immortal-sniper1/GMWPY_UPB2023/doc/BoM.xlsx

MOUSER part No | price [Euro] | amout min | recomaded amount |  | type
80-USEQGCDACH4100 | 90.5 | 1 | 1 | 90.5 | sensor CH4
523-EC4-1000-H2 | 158 | 1 | 1 | 158 | sensor H2
511-TSV7721ILT | 1.1 | 5 | 10 | 11 | op amp/buffer
926-LMP7717MFX/NOPB | 2.2 | 0 | 0 | 0 | op amp alt
863-MMBFJ177LT1G | 0.44 | 1 | 5 | 2.2 | Jfet p
595-LM4040D20IDBZR | 0.73 | 1 | 2 | 1.46 | reference 2.048V | https://ro.mouser.com/c/semiconductors/power-management-ics/voltage-references/?q=LM4040D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
356-ESP32S3WROM1N4R2 | 3.1 | 1 | 2 | 6.2 | MCU
640-USB1040-GF-L-B | 0.52 | 1 | 2 | 1.04 | USB
579-MCP3422A1-E/SN | 3.7 | 1 | 2 | 7.4 | ADC 18bit
579-MCP3422A0-E/SN | 3.7 | 1 | 2 | 7.4 | ADC 18bit | https://ro.mouser.com/c/semiconductors/data-converter-ics/analog-to-digital-converters-adc/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
262-BME280 | 6 | 1 | 2 | 12 | temp press hum sensor
Farnell
3546297 | 96 | 1 |  |  | CH4 sensor
1654684 | 0.4 | 3 | 10 | 4 | H2 sensor socket
JLCPCB
- | 39.5 | 1 | 1 | 39.5 | PCB+ pasive | remember that we can assemble 2 or 5 pieces with or without the MCU
 |  |  |  |  |  | All amounts are for 1 device
sensors | 254
te other parts | 92.2
total | 346.2
