immortal-sniper1/GMWPY_UPB2023/doc/USEQGCDACH4100.step

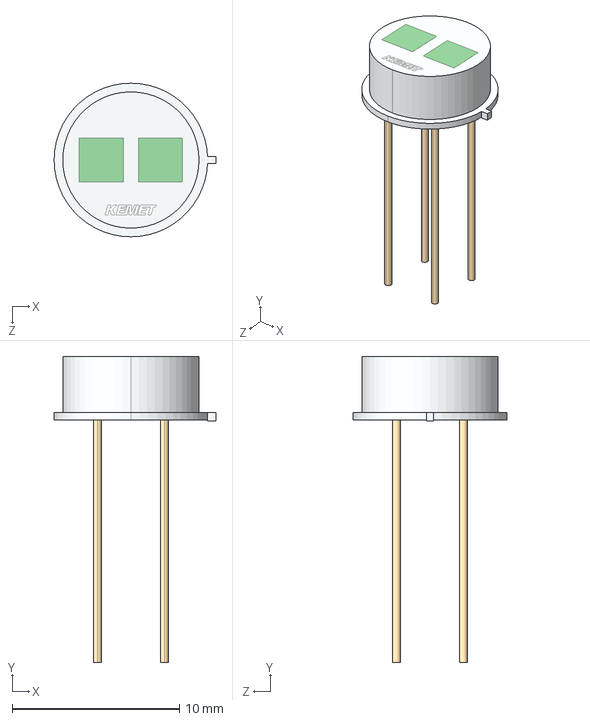
[picture p6: CAD file, 2023-03-01]
doc/USEQGCDACH4100.step
9.68 x 18.3 x 9.19 mm
