immortal-sniper1/GMWPY_UPB2023/HW/GMWPY/GMWPY.step

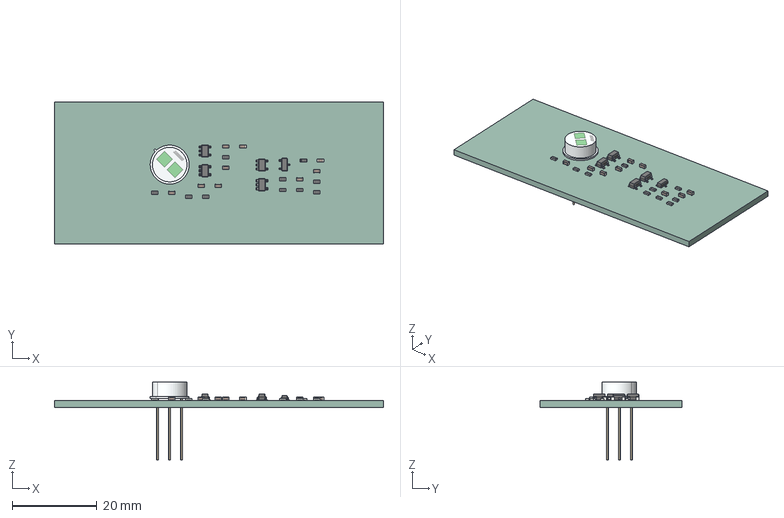
[picture p7: CAD file, 2023-03-01]
HW/GMWPY/GMWPY.step
77.6 x 33.4 x 18.3 mm
_autosave-GMWPY PCB
