immortal-sniper1/GMWPY_UPB2023/HW/schematic.pdf

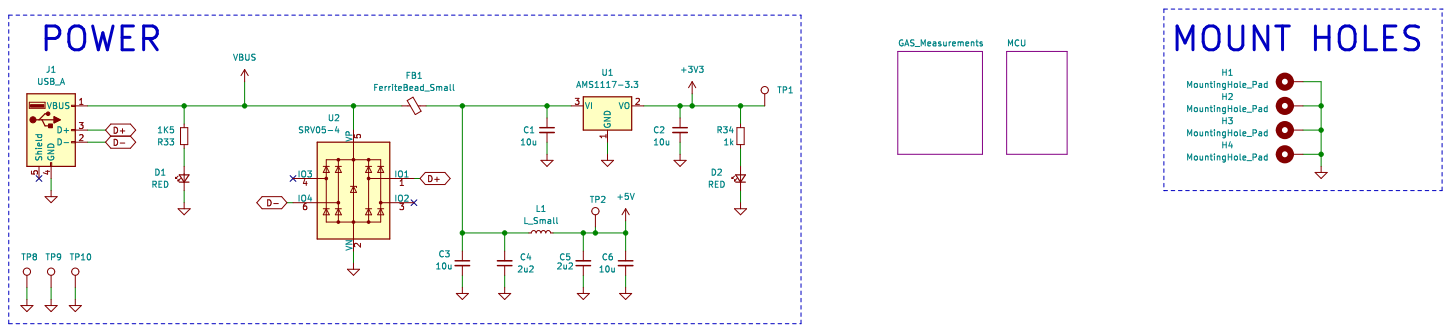
[picture p8: page 1]

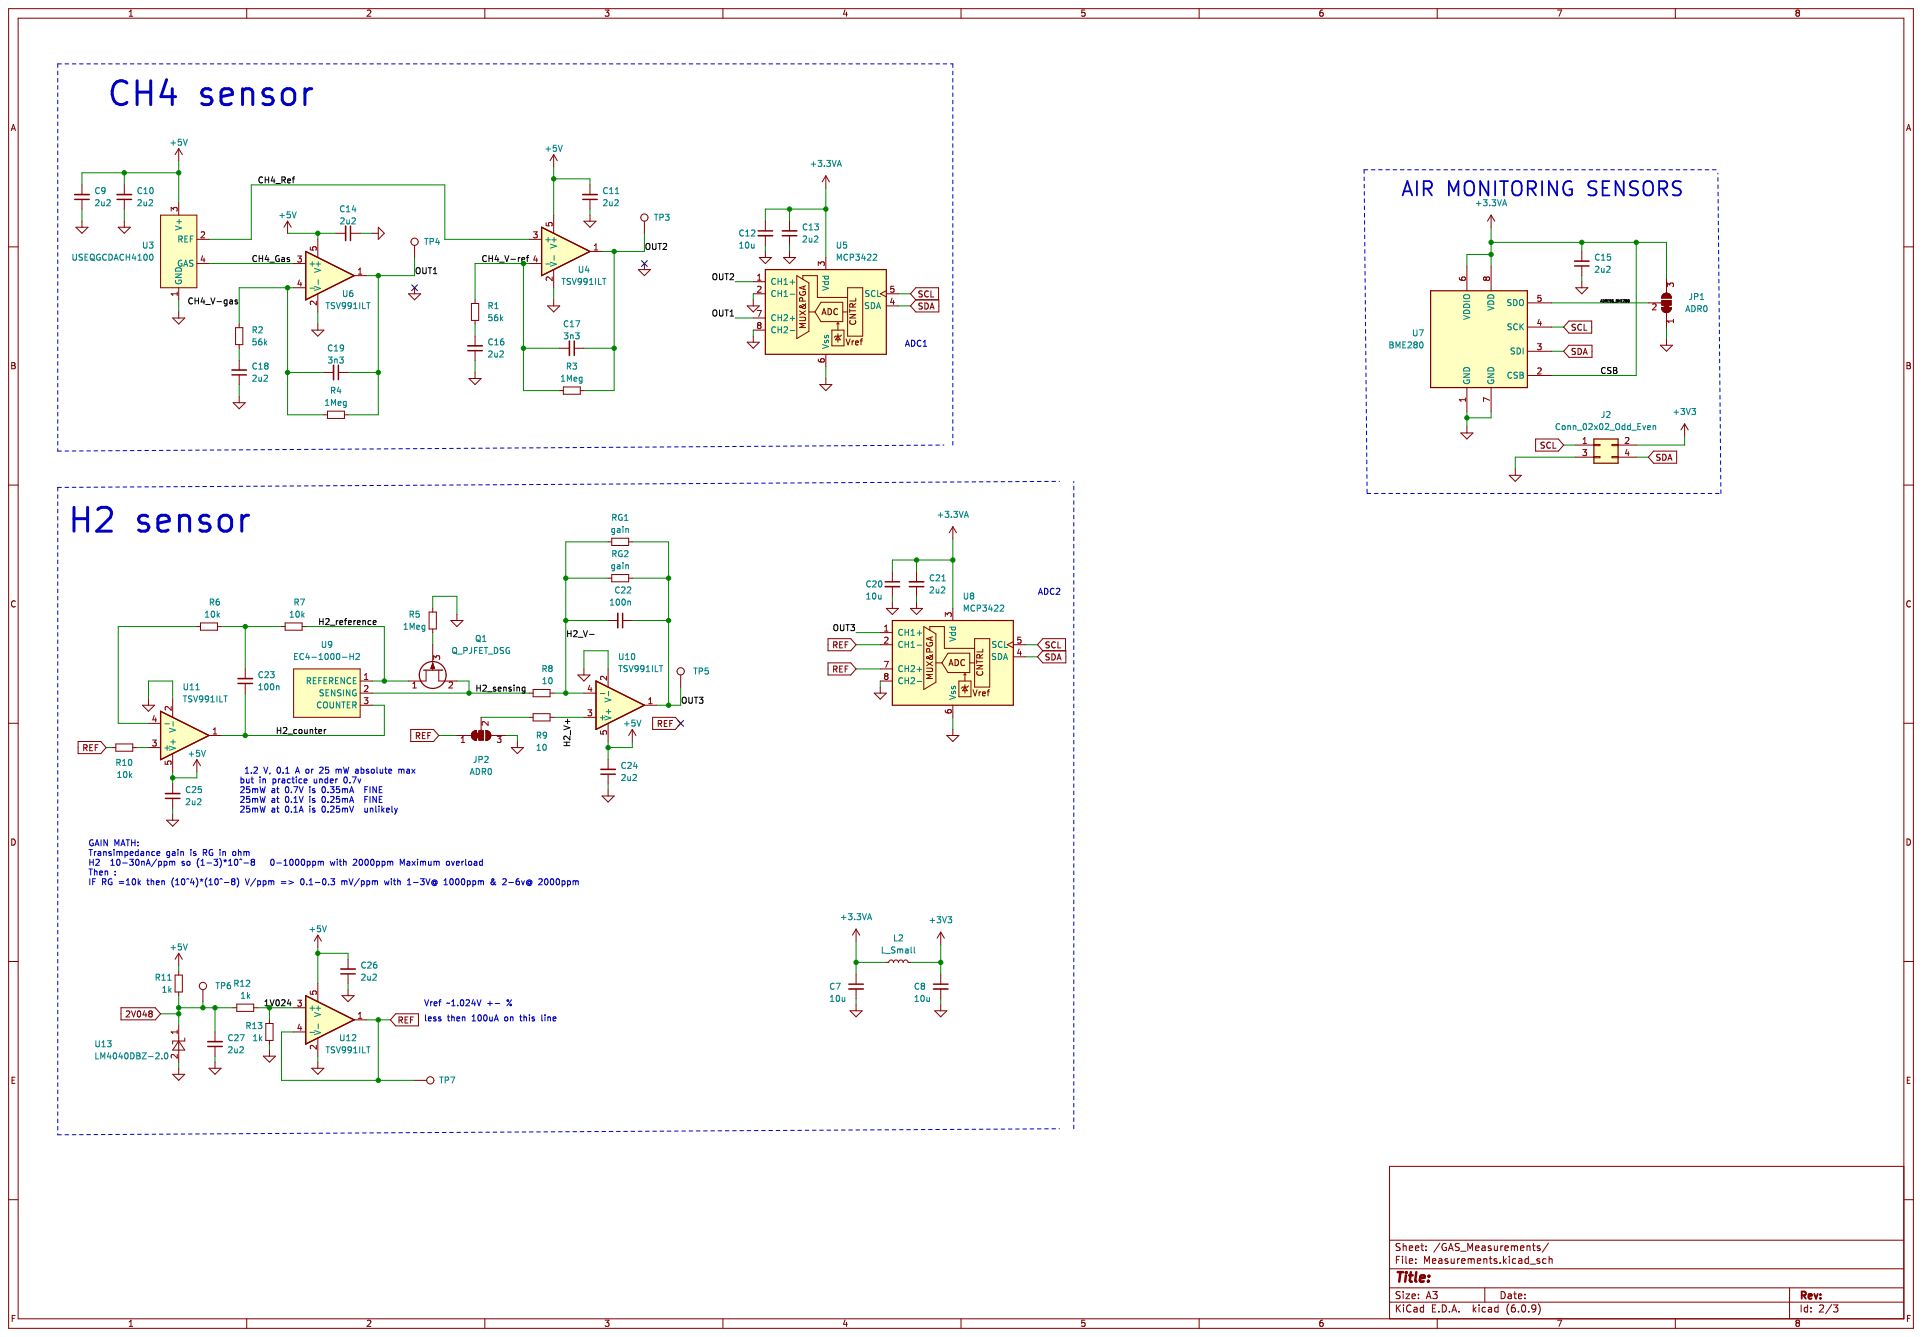
[picture p9: page 2]

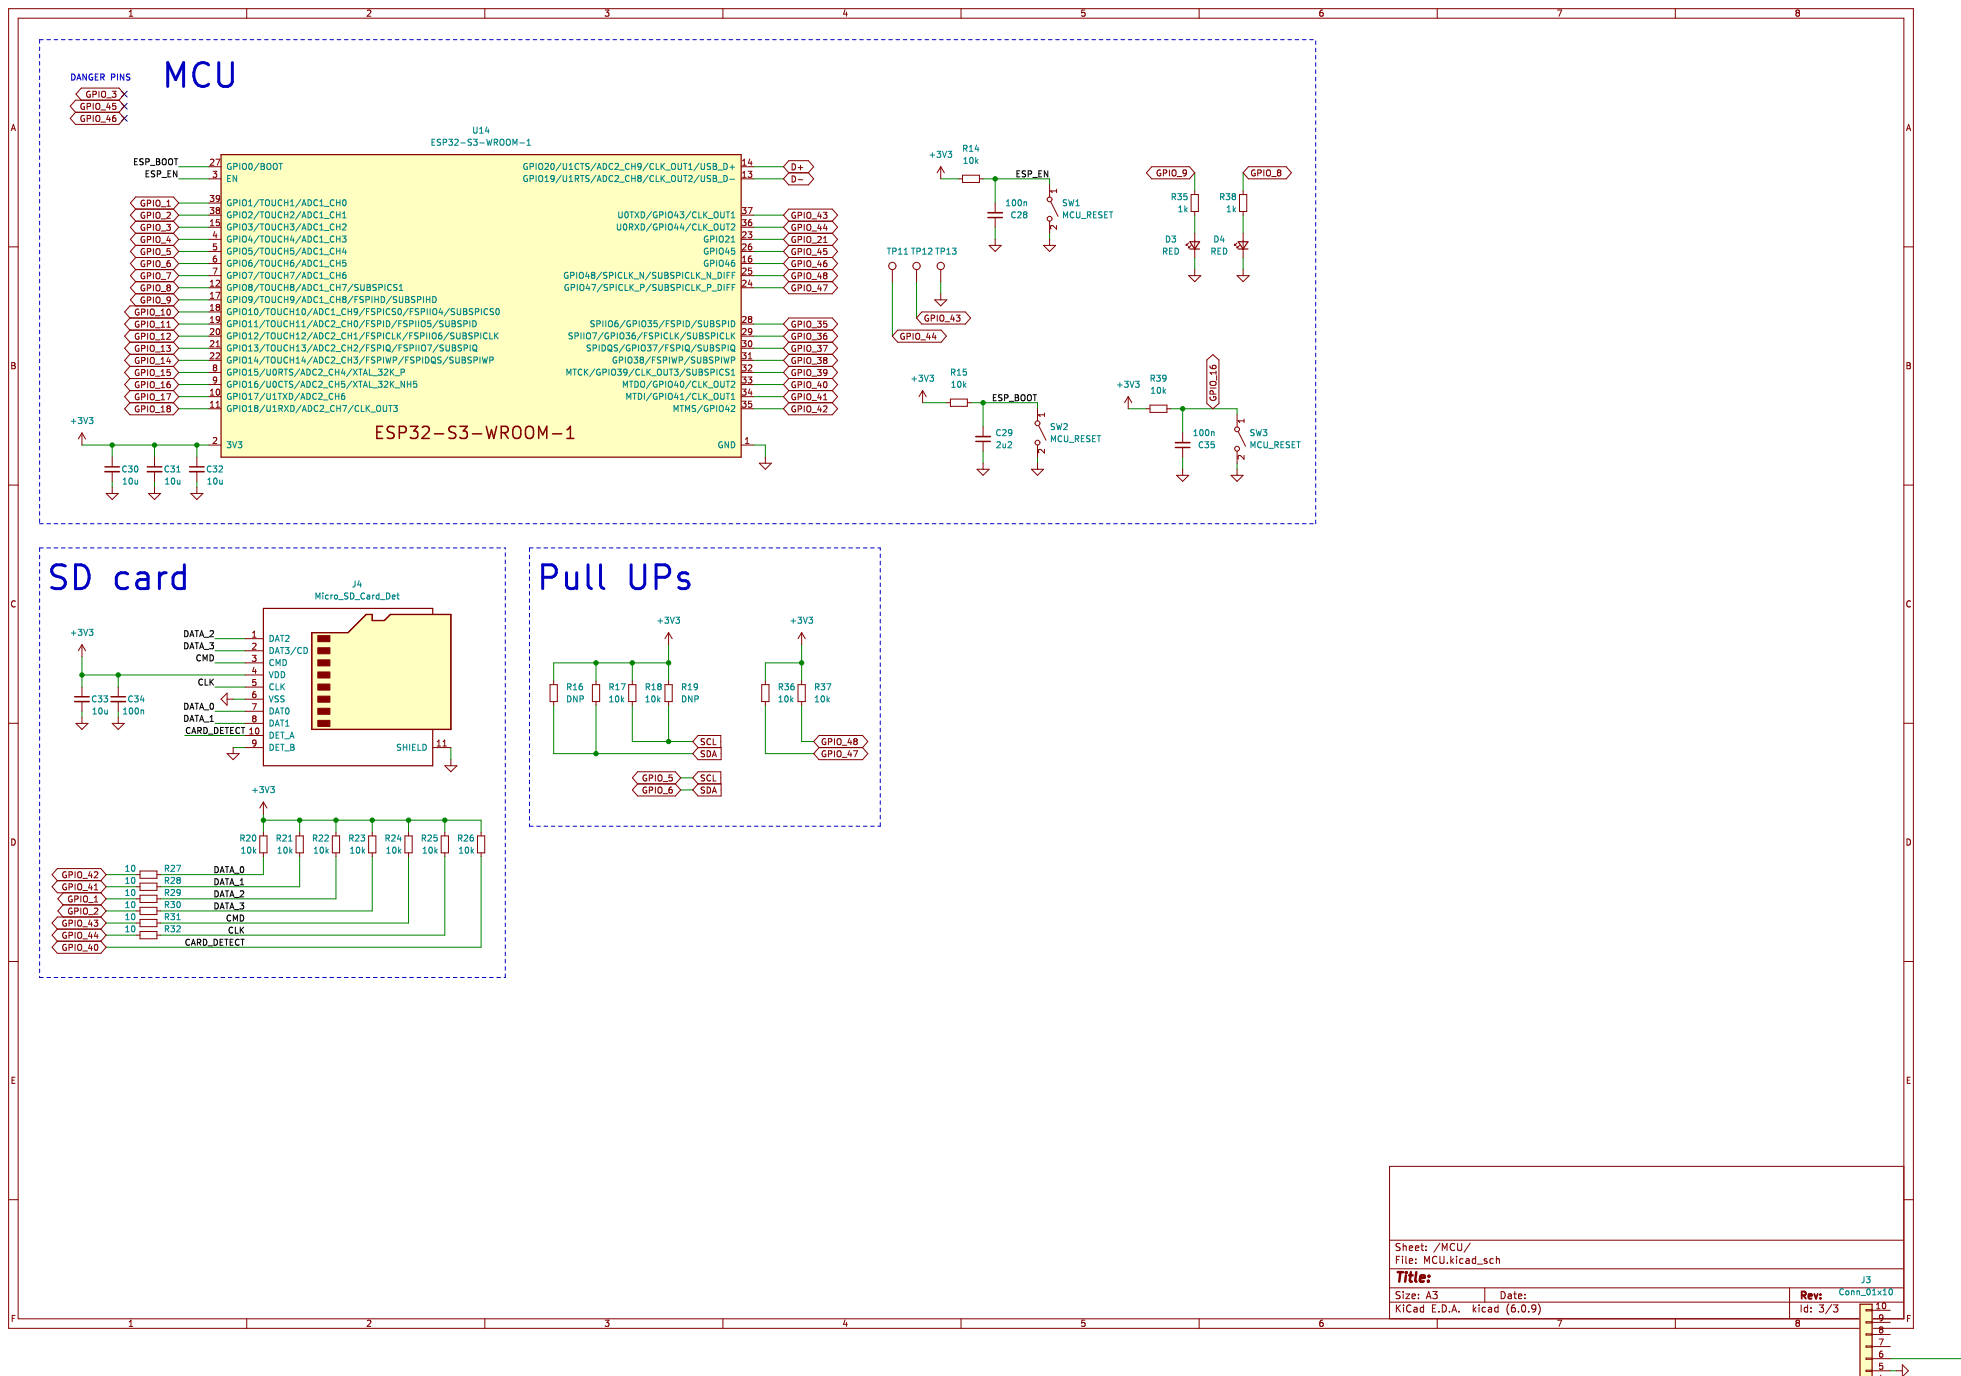
[picture p10: page 3]
