immortal-sniper1/GMWPY_UPB2023/HW/GMWPY/GMWPY.kicad_pcb

## KiCad design HW/GMWPY/GMWPY.kicad_pcb (2023-03-27)

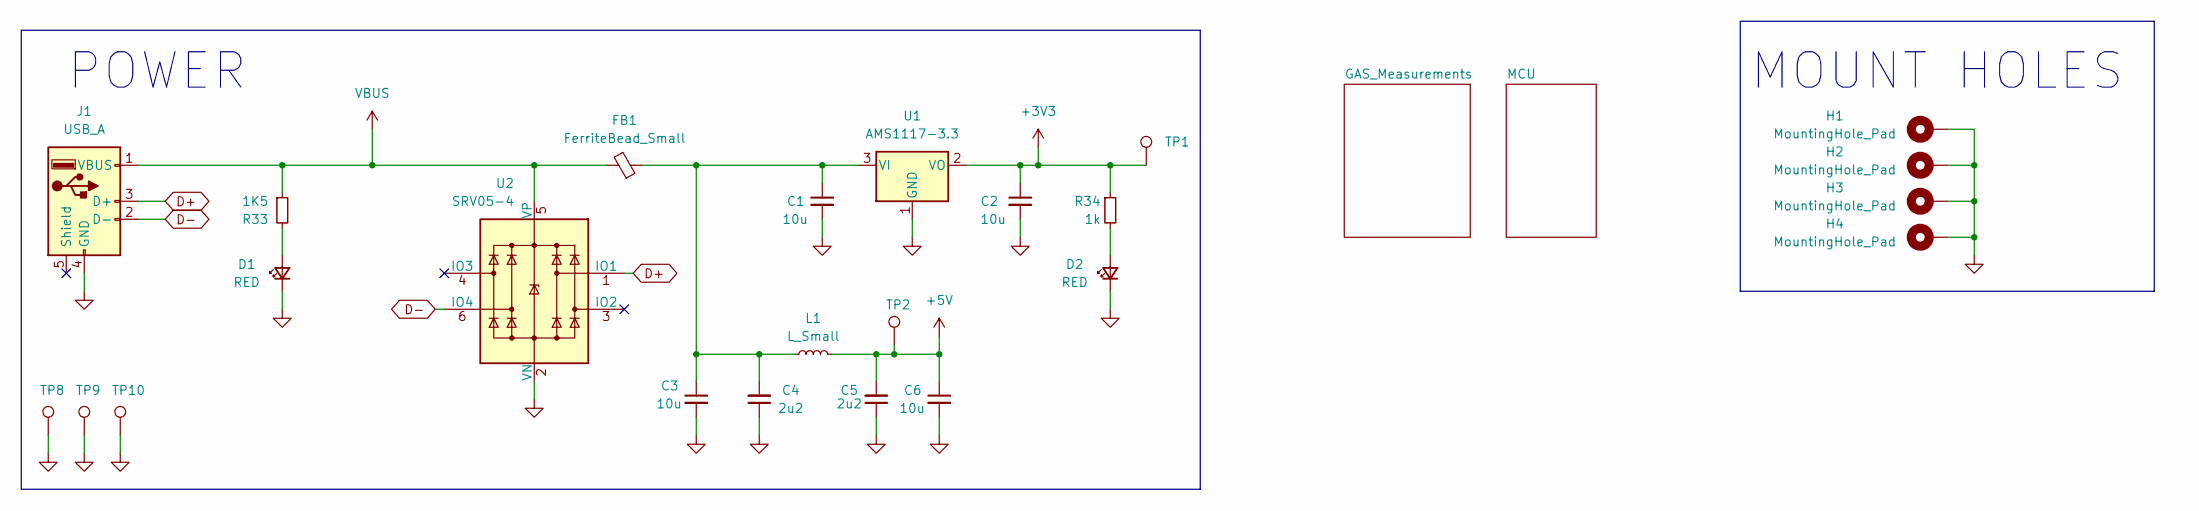
[picture p11: schematic GMWPY.kicad_sch, Gas_sensor_board]

Parts:
C1, C2, C3, C6: 10u; C_0805_2012Metric; LCSC C15850
C4, C5: 2u2; C_0603_1608Metric; LCSC C23630
D1, D2: RED; LED_0603_1608Metric; LCSC C2286
FB1: FerriteBead_Small; L_0805_2012Metric; LCSC C1015
H1, H2, H3, H4: MountingHole_Pad; MountingHole_3.2mm_M3_DIN965_Pad_TopBottom
J1: USB_A; USB1040GFLB
L1: L_Small; L_0603_1608Metric; LCSC C13415
R33: 1K5; R_0603_1608Metric; LCSC C22843
R34: 1k; R_0603_1608Metric; LCSC C21190
TP1, TP2, TP8, TP9, TP10: TestPoint; TestPoint_Pad_1.5x1.5mm
U1: AMS1117-3.3; SOT-223-3_TabPin2; LCSC C6186
U2: SRV05-4; SOT-23-6; LCSC C85364

Connections:
+3V3: C2.1, R34.1, TP1.1, U1.2 (VO); also elsewhere on the board
+5V: C5.2, C6.1, L1.2, TP2.1; also elsewhere on the board
D+: J1.3 (D+), U2.1 (IO1); also elsewhere on the board
D-: J1.2 (D-), U2.6 (IO4); also elsewhere on the board
GND: C1.2, C2.2, C3.2, C4.1, C5.1, C6.2, D1.1 (K), D2.1 (K), H1.1, H2.1, H3.1, H4.1, J1.4 (GND), TP8.1, TP9.1, TP10.1, U1.1 (GND), U2.2 (VN); also elsewhere on the board
unnamed: C1.1, C3.1, C4.2, FB1.1, L1.1, U1.3 (VI)
unnamed: D1.2 (A), R33.2
unnamed: D2.2 (A), R34.2
VBUS: FB1.2, J1.1 (VBUS), R33.1, U2.5 (VP); also elsewhere on the board

Notes on the sheet:
POWER
MOUNT HOLES

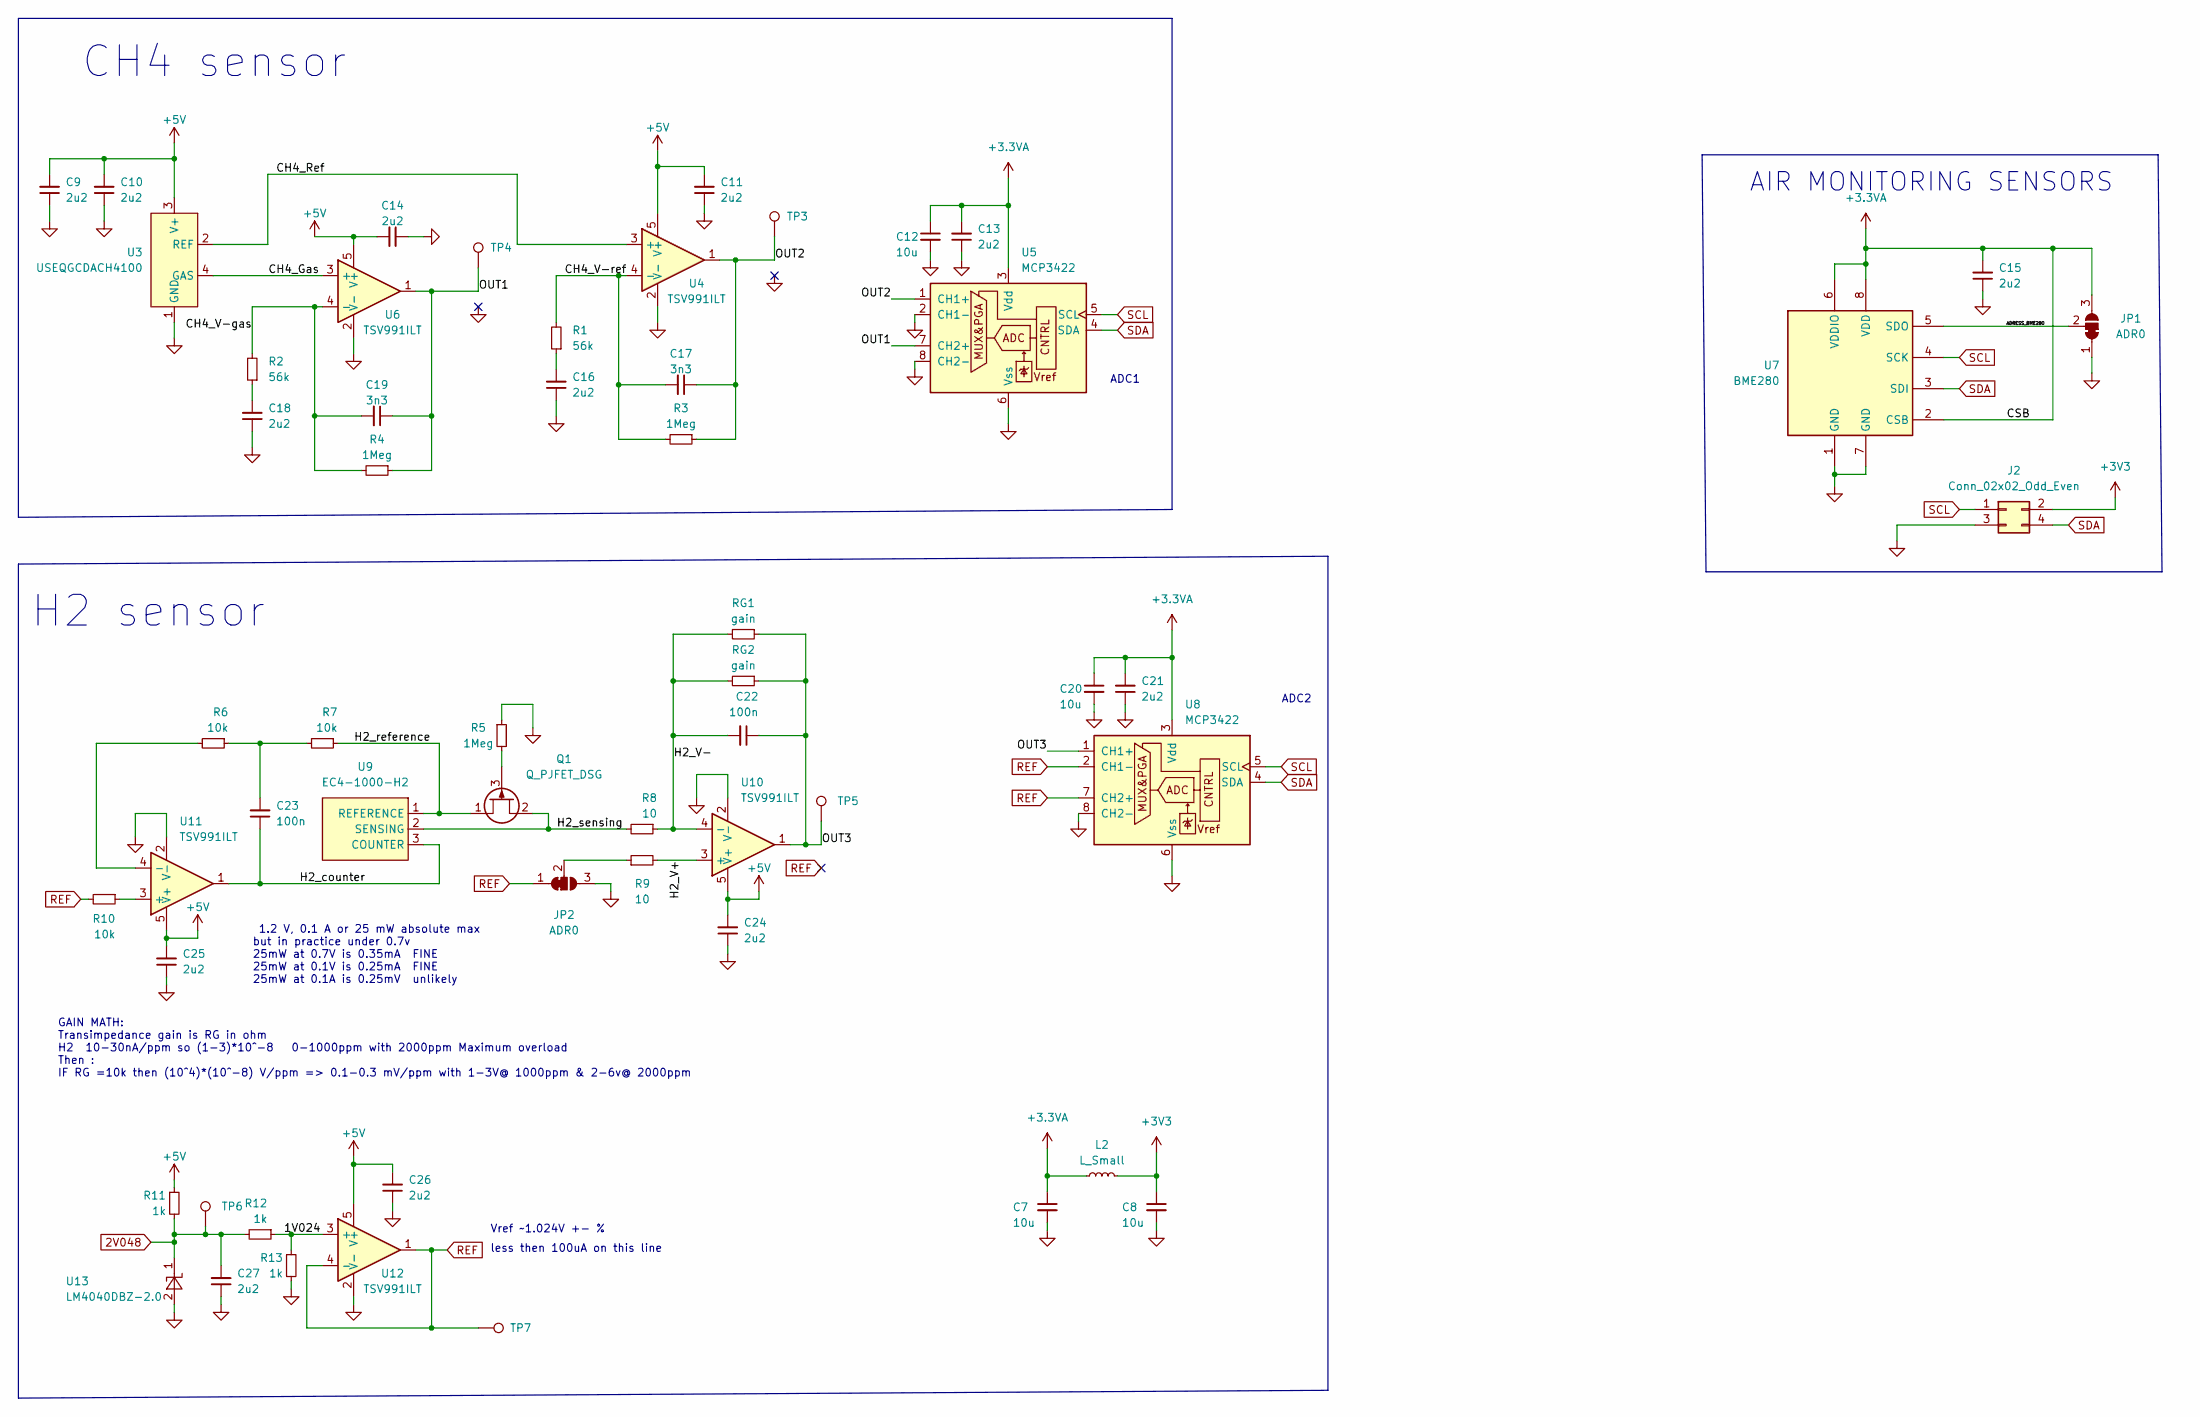
[picture p12: schematic Measurements.kicad_sch]

Parts:
C7, C8, C12, C20: 10u; C_0805_2012Metric; LCSC C15850
C9, C10, C11, C13, C14, C15, C16, C18, C21, C24, C25, C26, C27: 2u2; C_0603_1608Metric; LCSC C23630
C17, C19: 3n3; C_0603_1608Metric; LCSC C1613
C22, C23: 100n; C_0603_1608Metric; LCSC C14663
J2: Conn_02x02_Odd_Even; PinHeader_2x02_P2.54mm_Vertical
JP1, JP2: ADR0; SolderJumper-3_P1.3mm_Bridged12_RoundedPad1.0x1.5mm_NumberL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
L2: L_Small; L_0603_1608Metric; LCSC C13415
Q1: Q_PJFET_DSG; SOT-23; LCSC C106763
R1, R2: 56k; R_0603_1608Metric; LCSC C23206
R3, R4, R5: 1Meg; R_0603_1608Metric; LCSC C22935
R6, R7, R10: 10k; R_0603_1608Metric; LCSC C25804
R8, R9: 10; R_0603_1608Metric; LCSC C22859
R11, R12, R13: 1k; R_0603_1608Metric; LCSC C21190
RG1: gain; R_0603_1608Metric; LCSC x
RG2: gain; R_0603_1608Metric; LCSC C25804
TP3, TP4, TP5, TP6, TP7: TestPoint; TestPoint_Pad_1.5x1.5mm
U3: USEQGCDACH4100; KEMET-4-PIN-GAS-SENSOR; MOUSER 80-USEQGCDACH4100
U4, U6, U10, U11, U12: TSV991ILT; SOT-23-5_HandSoldering; LCSC C157443
U5, U8: MCP3422; SOIC-8_3.9x4.9mm_P1.27mm
U7: BME280; Bosch_LGA-8_2.5x2.5mm_P0.65mm_ClockwisePinNumbering
U9: EC4-1000-H2; EC4-3pin; MOUSER 523-EC4-1000-H2
U13: LM4040DBZ-2.0; SOT-23; LCSC C431732

Connections:
2V048: C27.2, R11.2, R12.2, TP6.1, U13.1 (K)
+3.3VA: C7.1, C12.1, C13.2, C15.2, C20.1, C21.2, JP1.3 (B), L2.1, U5.3 (Vdd), U7.2 (CSB), U7.6 (VDDIO), U7.8 (VDD), U8.3 (Vdd)
+3V3: C8.1, J2.2, L2.2; also elsewhere on the board
+5V: C9.2, C10.2, C11.2, C14.2, C24.2, C25.2, C26.2, R11.1, U3.3 (V+), U4.5 (V+), U6.5 (V+), U10.5 (V+), U11.5 (V+), U12.5 (V+); also elsewhere on the board
/GAS_Measurements/1V024: R12.1, R13.1, U12.3 (+)
/GAS_Measurements/ADRESS_BME280: JP1.2 (C), U7.5 (SDO)
/GAS_Measurements/CH4_Gas: U3.4 (GAS), U6.3 (+)
/GAS_Measurements/CH4_Ref: U3.2 (REF), U4.3 (+)
/GAS_Measurements/CH4_V-gas: C19.2, R2.2, R4.2, U6.4 (-)
/GAS_Measurements/CH4_V-ref: C17.2, R1.2, R3.2, U4.4 (-)
/GAS_Measurements/H2_V+: R9.2, U10.3 (+)
/GAS_Measurements/H2_V-: C22.2, R8.1, RG1.2, RG2.2, U10.4 (-)
/GAS_Measurements/H2_counter: C23.1, U9.3 (COUNTER), U11.1
/GAS_Measurements/H2_reference: Q1.1 (D), R7.1, U9.1 (REFERENCE)
/GAS_Measurements/H2_sensing: Q1.2 (S), R8.2, U9.2 (SENSING)
/GAS_Measurements/OUT1: C19.1, R4.1, TP4.1, U5.7 (CH2+), U6.1
/GAS_Measurements/OUT2: C17.1, R3.1, TP3.1, U4.1, U5.1 (CH1+)
/GAS_Measurements/OUT3: C22.1, RG1.1, RG2.1, TP5.1, U8.1 (CH1+), U10.1
GND: C7.2, C8.2, C9.1, C10.1, C11.1, C12.2, C13.1, C14.1, C15.1, C16.1, C18.1, C20.2, C21.1, C24.1, C25.1, C26.1, C27.1, J2.3, JP1.1 (A), JP2.3 (B), R5.1, R13.2, U3.1 (GND), U4.2 (V-), U5.2 (CH1-), U5.6 (Vss), U5.8 (CH2-), U6.2 (V-), U7.1 (GND), U7.7 (GND), U8.6 (Vss), U8.8 (CH2-), U10.2 (V-), U11.2 (V-), U12.2 (V-), U13.2 (A); also elsewhere on the board
GPIO_5: J2.1, U5.5 (SCL), U7.4 (SCK), U8.5 (SCL); also elsewhere on the board
GPIO_6: J2.4, U5.4 (SDA), U7.3 (SDI), U8.4 (SDA); also elsewhere on the board
unnamed: C16.2, R1.1
unnamed: C18.2, R2.1
unnamed: C23.2, R6.1, R7.2
unnamed: JP2.2 (C), R9.1
unnamed: Q1.3 (G), R5.2
unnamed: R6.2, U11.4 (-)
unnamed: R10.1, U11.3 (+)
REF: JP2.1 (A), R10.2, TP7.1, U8.2 (CH1-), U8.7 (CH2+), U12.1, U12.4 (-)

Notes on the sheet:
GAIN MATH: Transimpedance gain is RG in ohm H2 10-30nA/ppm so (1-3)*10^-8 0-1000ppm with 2000ppm Maximum overload Then : IF RG =10k then (10^4)*(10^-8) V/ppm => 0.1-0.3 mV/ppm with 1-3V@ 1000ppm & 2-6v@ 2000ppm
Vref ~1.024V +- %
AIR MONITORING SENSORS
ADC1
less then 100uA on this line
CH4 sensor
1.2 V, 0.1 A or 25 mW absolute max but in practice under 0.7v 25mW at 0.7V is 0.35mA FINE 25mW at 0.1V is 0.25mA FINE 25mW at 0.1A is 0.25mV unlikely
H2 sensor
ADC2

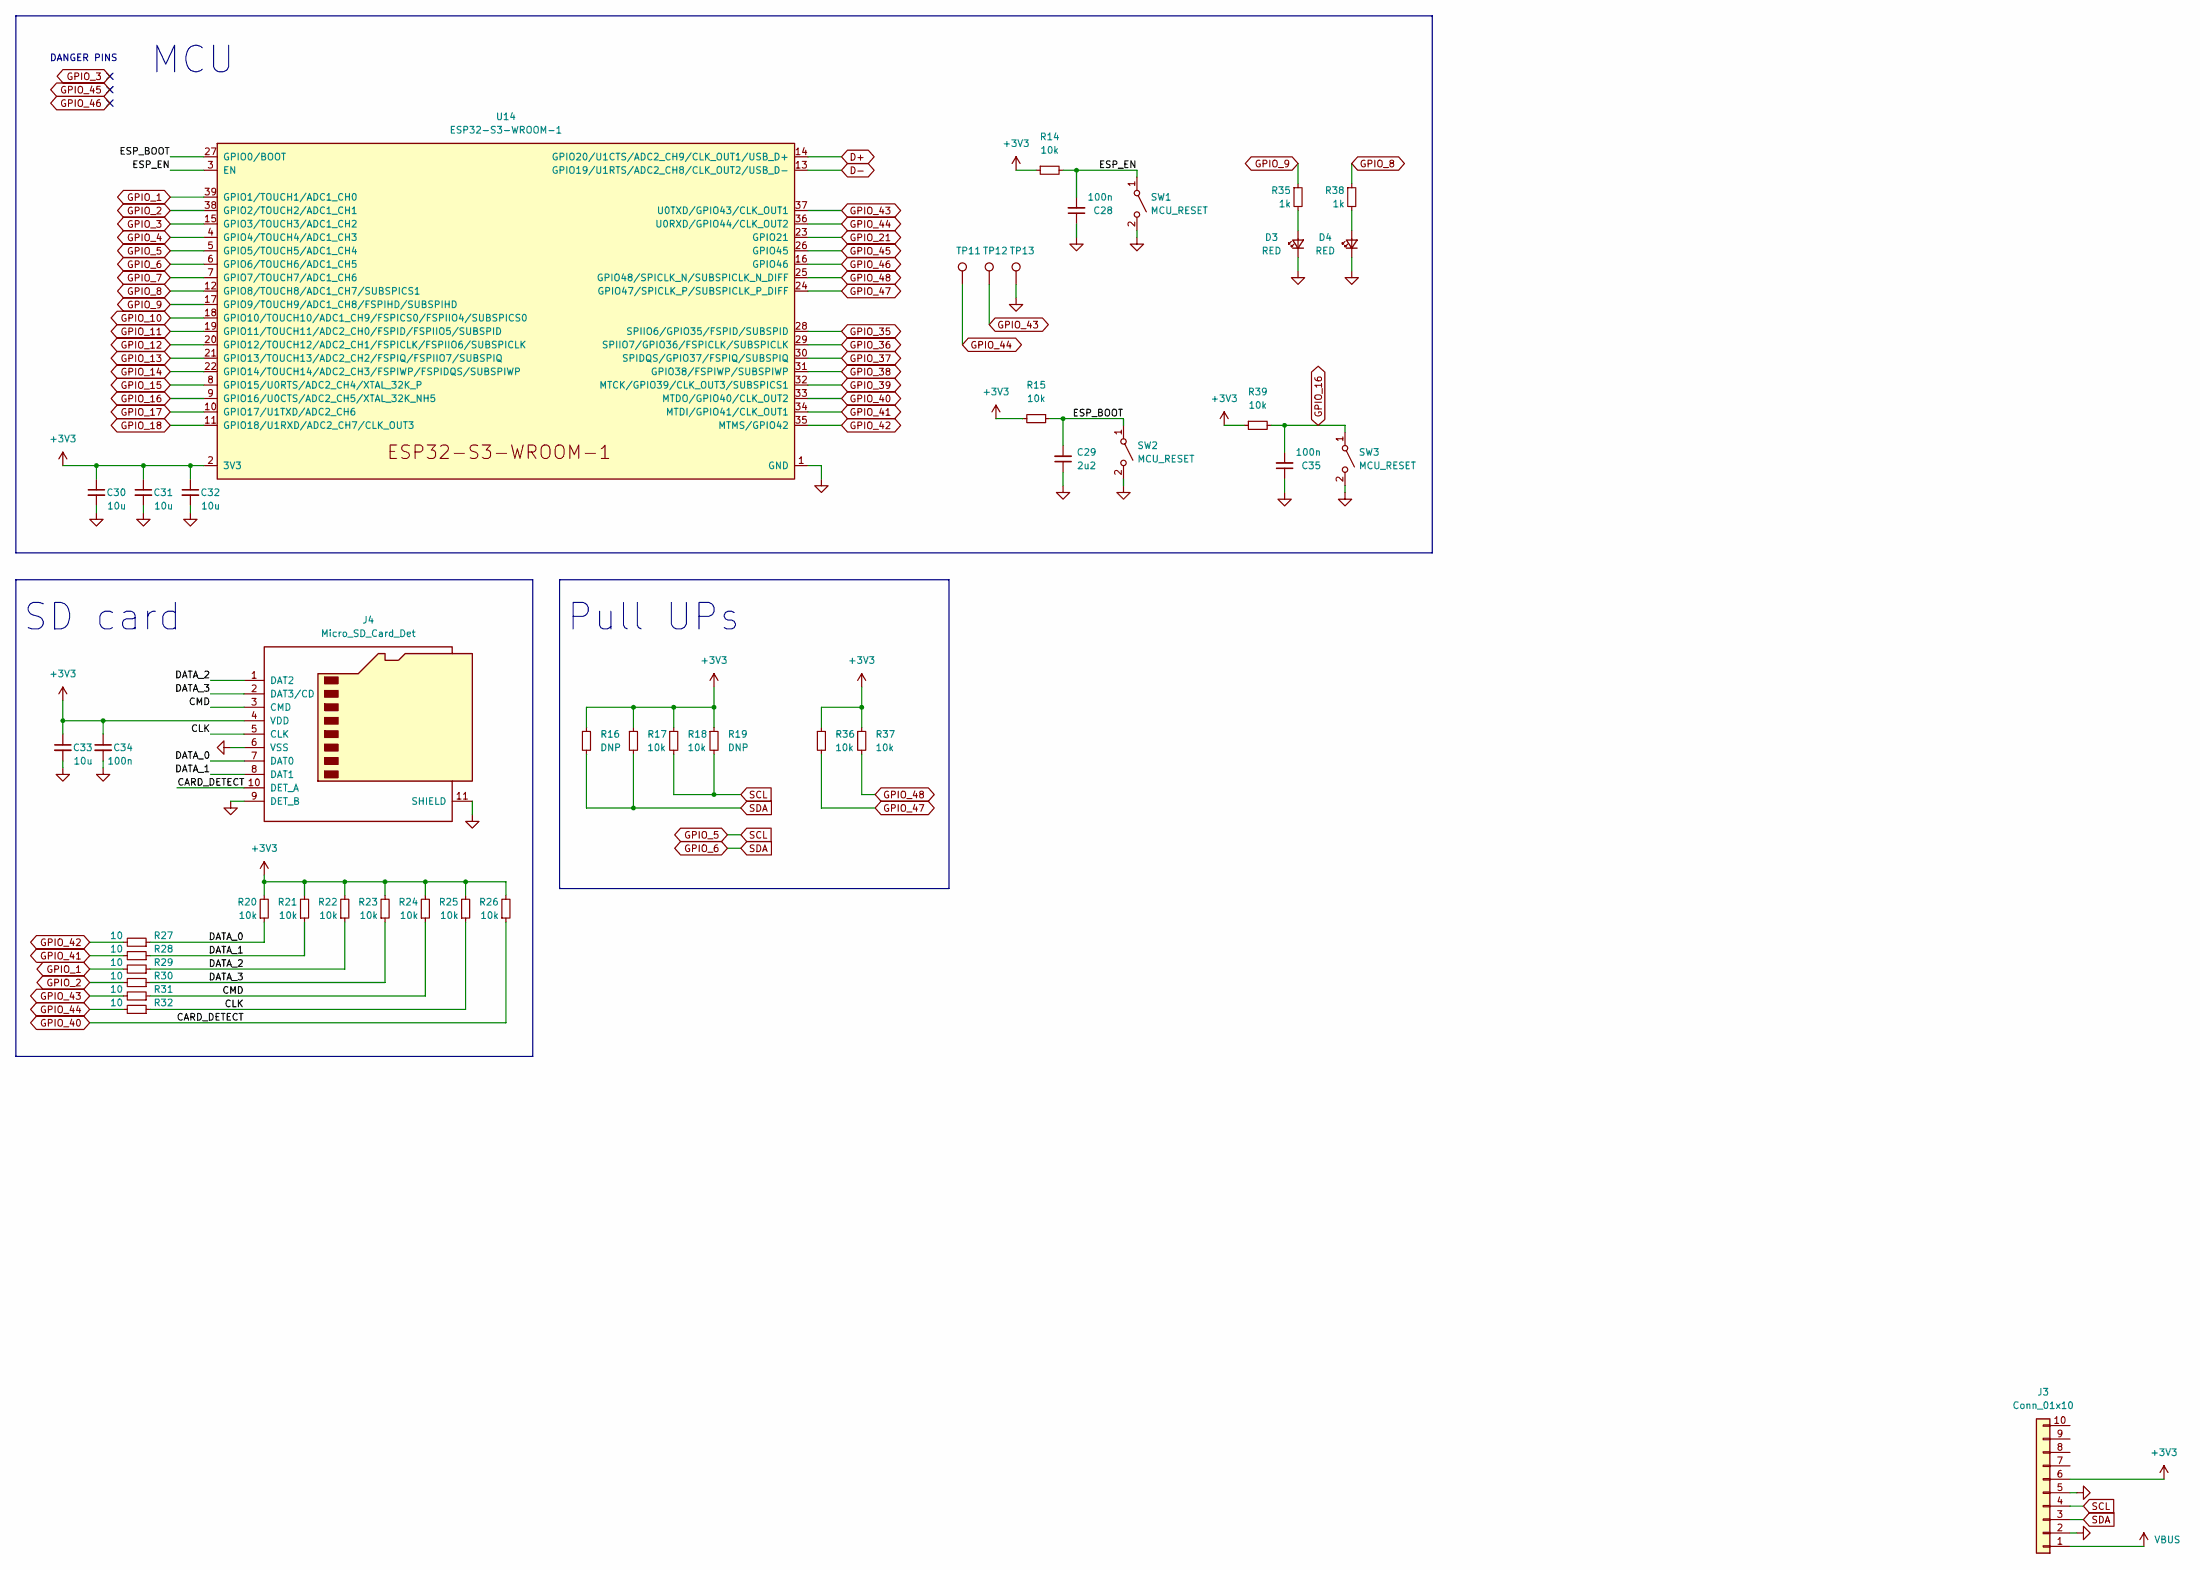
[picture p13: schematic MCU.kicad_sch]

Parts:
C28, C34, C35: 100n; C_0603_1608Metric_Pad1.08x0.95mm_HandSolder; LCSC C14663
C29: 2u2; C_0603_1608Metric; LCSC C23630
C30, C31, C32, C33: 10u; C_0805_2012Metric; LCSC C15850
D3, D4: RED; LED_0603_1608Metric; LCSC C2286
J3: Conn_01x10; PinHeader_1x06_P2.54mm_Vertical
J4: Micro_SD_Card_Det; microSD_HC_Molex_104031-0811; LCSC C585350
R14, R15, R17, R18, R36, R37, R39: 10k; R_0603_1608Metric_Pad0.98x0.95mm_HandSolder; LCSC C25804
R16, R19: DNP; R_0603_1608Metric_Pad0.98x0.95mm_HandSolder
R20, R21, R22, R23, R24, R25, R26: 10k; R_0402_1005Metric; LCSC C25744
R27, R28, R29, R30, R31, R32: 10; R_0402_1005Metric; LCSC C25077
R35, R38: 1k; R_0603_1608Metric; LCSC C21190
SW1, SW2, SW3: MCU_RESET; PTS526SK15SMTR2LFS; LCSC C318884
TP11, TP12, TP13: TestPoint; TestPoint_Pad_1.5x1.5mm
U14: ESP32-S3-WROOM-1; LCSC C2913204

Connections:
+3V3: C30.1, C31.1, C32.1, C33.1, C34.1, J3.6, J4.4 (VDD), R14.1, R15.2, R16.1, R17.1, R18.1, R19.1, R20.2, R21.2, R22.2, R23.2, R24.2, R25.2, R26.2, R36.1, R37.1, R39.1, U14.2 (3V3); also elsewhere on the board
/MCU/CLK: J4.5 (CLK), R25.1, R32.1
/MCU/CMD: J4.3 (CMD), R24.1, R31.1
/MCU/DATA_0: J4.7 (DAT0), R20.1, R27.1
/MCU/DATA_1: J4.8 (DAT1), R21.1, R28.1
/MCU/DATA_2: J4.1 (DAT2), R22.1, R29.1
/MCU/DATA_3: J4.2 (DAT3/CD), R23.1, R30.1
/MCU/ESP_BOOT: C29.2, R15.1, SW2.1 (A), U14.27 (GPIO0/BOOT)
/MCU/ESP_EN: C28.2, R14.2, SW1.1 (A), U14.3 (EN)
D+: U14.14 (GPIO20/U1CTS/ADC2_CH9/CLK_OUT1/USB_D+); also elsewhere on the board
D-: U14.13 (GPIO19/U1RTS/ADC2_CH8/CLK_OUT2/USB_D-); also elsewhere on the board
GND: C28.1, C29.1, C30.2, C31.2, C32.2, C33.2, C34.2, C35.1, D3.1 (K), D4.1 (K), J3.2, J3.5, J4.6 (VSS), J4.9 (DET_B), J4.11 (SHIELD), SW1.2 (B), SW2.2 (B), SW3.2 (B), TP13.1, U14.1 (GND), U14.40 (GND), U14.41 (GND); also elsewhere on the board
GPIO_1: R29.2, U14.39 (GPIO1/TOUCH1/ADC1_CH0)
GPIO_2: R30.2, U14.38 (GPIO2/TOUCH2/ADC1_CH1)
GPIO_3: U14.15 (GPIO3/TOUCH3/ADC1_CH2)
GPIO_4: U14.4 (GPIO4/TOUCH4/ADC1_CH3)
GPIO_5: J3.4, R18.2, R19.2, U14.5 (GPIO5/TOUCH5/ADC1_CH4); also elsewhere on the board
GPIO_6: J3.3, R16.2, R17.2, U14.6 (GPIO6/TOUCH6/ADC1_CH5); also elsewhere on the board
GPIO_7: U14.7 (GPIO7/TOUCH7/ADC1_CH6)
GPIO_8: R38.1, U14.12 (GPIO8/TOUCH8/ADC1_CH7/SUBSPICS1)
GPIO_9: R35.1, U14.17 (GPIO9/TOUCH9/ADC1_CH8/FSPIHD/SUBSPIHD)
GPIO_10: U14.18 (GPIO10/TOUCH10/ADC1_CH9/FSPICS0/FSPIIO4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)
GPIO_11: U14.19 (GPIO11/TOUCH11/ADC2_CH0/FSPID/FSPIIO5/S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)
GPIO_12: U14.20 (GPIO12/TOUCH12/ADC2_CH1/FSPICLK/FSPIIO6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)
GPIO_13: U14.21 (GPIO13/TOUCH13/ADC2_CH2/FSPIQ/FSPIIO7/S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)
GPIO_14: U14.22 (GPIO14/TOUCH14/ADC2_CH3/FSPIWP/FSPIDQS/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)
GPIO_15: U14.8 (GPIO15/U0RTS/ADC2_CH4/XTAL_32K_P)
GPIO_16: C35.2, R39.2, SW3.1 (A), U14.9 (GPIO16/U0CTS/ADC2_CH5/XTAL_32K_NH5)
GPIO_17: U14.10 (GPIO17/U1TXD/ADC2_CH6)
GPIO_18: U14.11 (GPIO18/U1RXD/ADC2_CH7/CLK_OUT3)
GPIO_21: U14.23 (GPIO21)
GPIO_35: U14.28 (SPIIO6/GPIO35/FSPID/SUBSPID)
GPIO_36: U14.29 (SPIIO7/GPIO36/FSPICLK/SUBSPICLK)
GPIO_37: U14.30 (SPIDQS/GPIO37/FSPIQ/SUBSPIQ)
GPIO_38: U14.31 (GPIO38/FSPIWP/SUBSPIWP)
GPIO_39: U14.32 (MTCK/GPIO39/CLK_OUT3/SUBSPICS1)
GPIO_40: J4.10 (DET_A), R26.1, U14.33 (MTDO/GPIO40/CLK_OUT2)
GPIO_41: R28.2, U14.34 (MTDI/GPIO41/CLK_OUT1)
GPIO_42: R27.2, U14.35 (MTMS/GPIO42)
GPIO_43: R31.2, TP12.1, U14.37 (U0TXD/GPIO43/CLK_OUT1)
GPIO_44: R32.2, TP11.1, U14.36 (U0RXD/GPIO44/CLK_OUT2)
GPIO_45: U14.26 (GPIO45)
GPIO_46: U14.16 (GPIO46)
GPIO_47: R36.2, U14.24 (GPIO47/SPICLK_P/SUBSPICLK_P_DIFF)
GPIO_48: R37.2, U14.25 (GPIO48/SPICLK_N/SUBSPICLK_N_DIFF)
unnamed: D3.2 (A), R35.2
unnamed: D4.2 (A), R38.2
VBUS: J3.1; also elsewhere on the board

Notes on the sheet:
Pull UPs
DANGER PINS
MCU
SD card

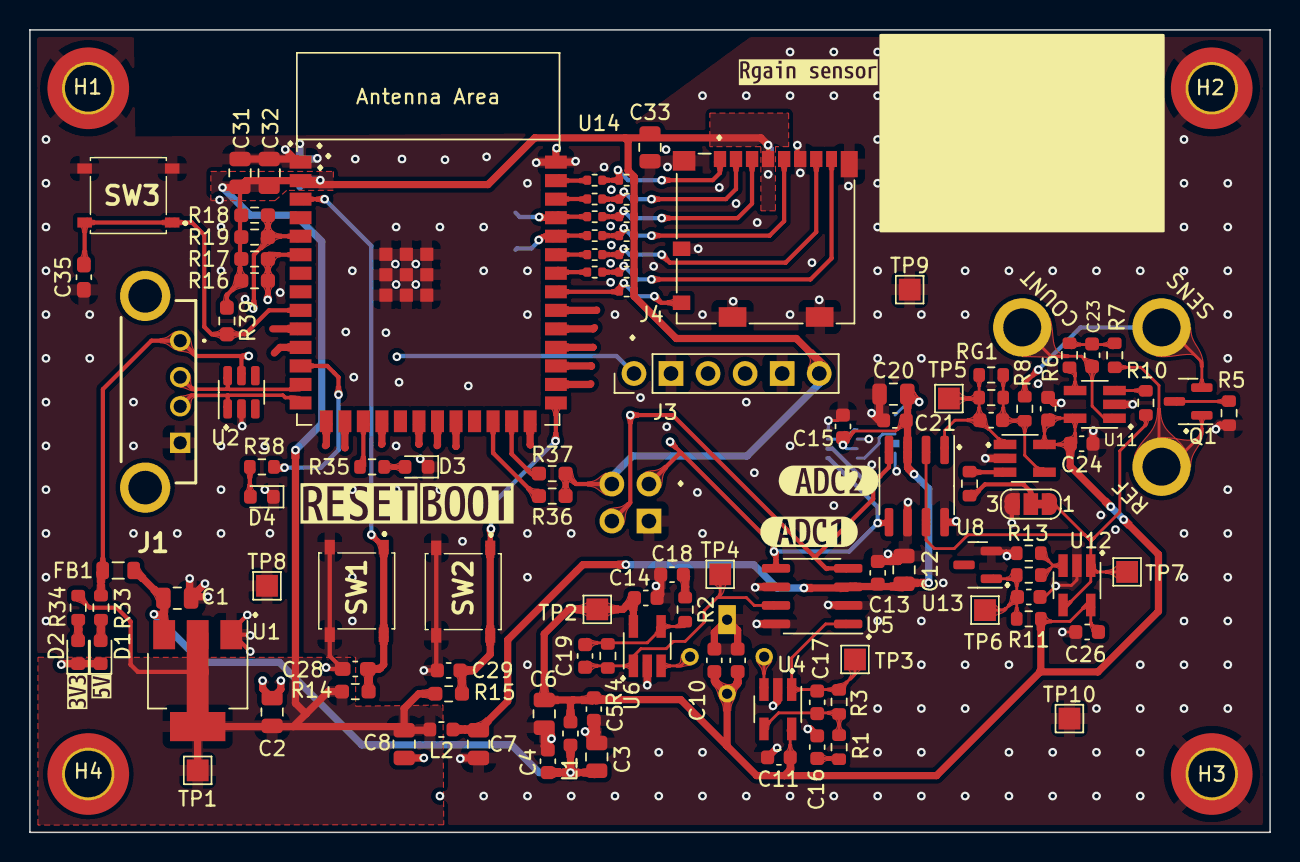
[picture p14: board GMWPY.kicad_pcb from above]

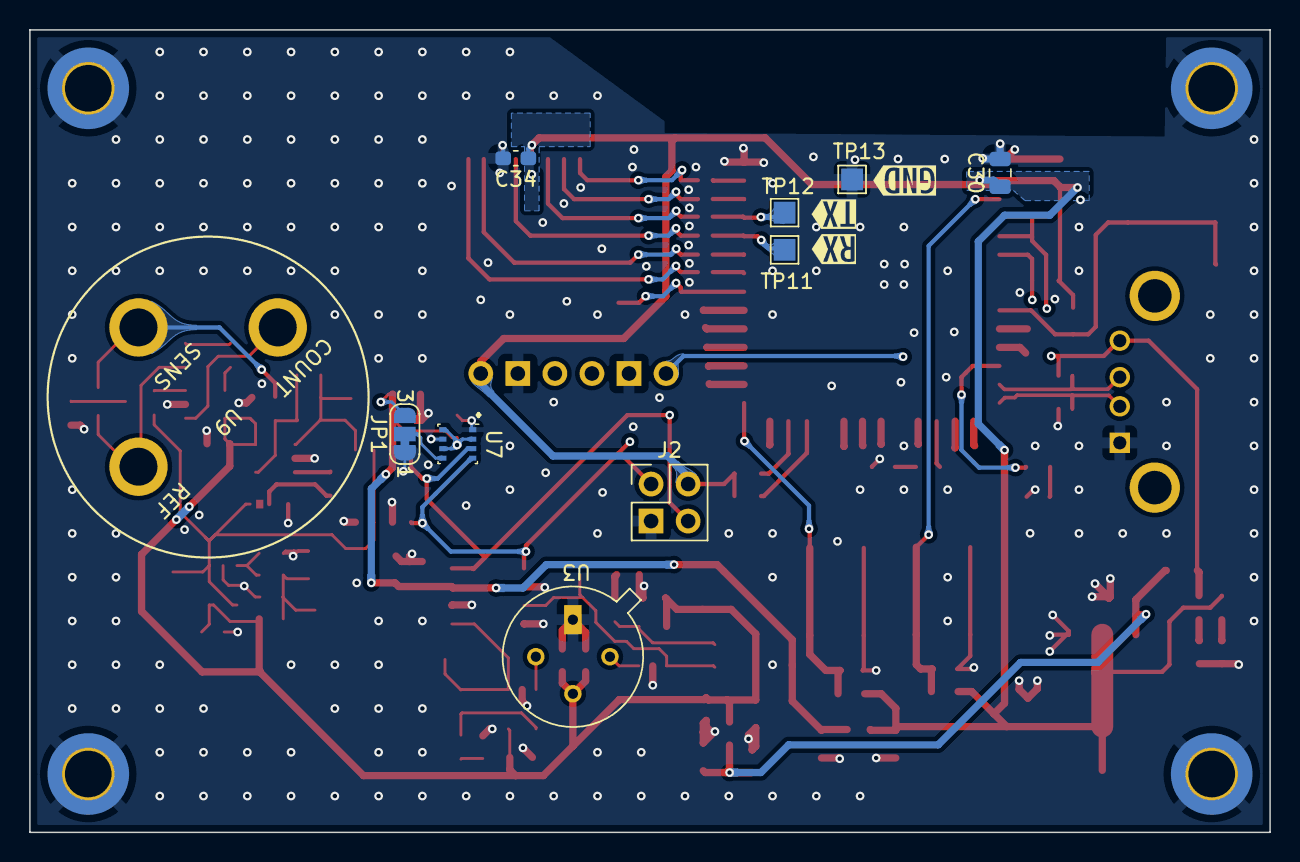
[picture p15: board GMWPY.kicad_pcb from below]

Board: 4 copper layers, 85.0 x 55.0 mm, 134 parts (13 on the bottom side), 57 nets.

Other parts of the board:
kibuzzard-6406DECD: G***; kibuzzard-6406DECD
kibuzzard-6406DEDF: G***; kibuzzard-6406DEDF
kibuzzard-6406E44E: G***; kibuzzard-6406E44E
kibuzzard-6406E441: G***; kibuzzard-6406E441
kibuzzard-640733B2: G***; kibuzzard-640733B2
kibuzzard-640843D3: G***; kibuzzard-640843D3
kibuzzard-640843E2: G***; kibuzzard-640843E2
kibuzzard-642169AB: G***; kibuzzard-642169AB
kibuzzard-642169BA: G***; kibuzzard-642169BA
kibuzzard-642169F1: G***; kibuzzard-642169F1
