immortal-sniper1/GMWPY_UPB2023/SW/ARDUINO_IDE/Arduino_OTA1/Arduino_OTA1.ino

#define ESP32_RTOS  // Uncomment this line if you want to use the code with freertos only on the ESP32
                    // Has to be done before including "OTA.h"

#include "OTA.h"
#include "credentials.h"

void setup() 
{
  Serial.begin(115200);
  Serial.println("Booting");

  setupOTA("OTA_test1_S3_MB", mySSID, myPASSWORD);

  // Your setup code
}

void loop() 
{
#ifdef defined(ESP32_RTOS) && defined(ESP32)
#else // If you do not use FreeRTOS, you have to regulary call the handle method.
  ArduinoOTA.handle();
#endif

  // Your code here
}
